tomcourt/enguino/Enguino.jpg

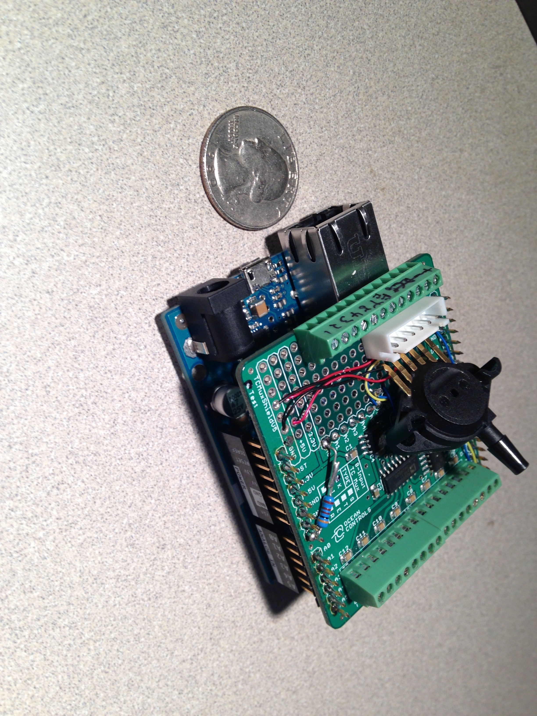
Enguino.jpg
