tomcourt/enguino/AuxDisplayBack.jpg

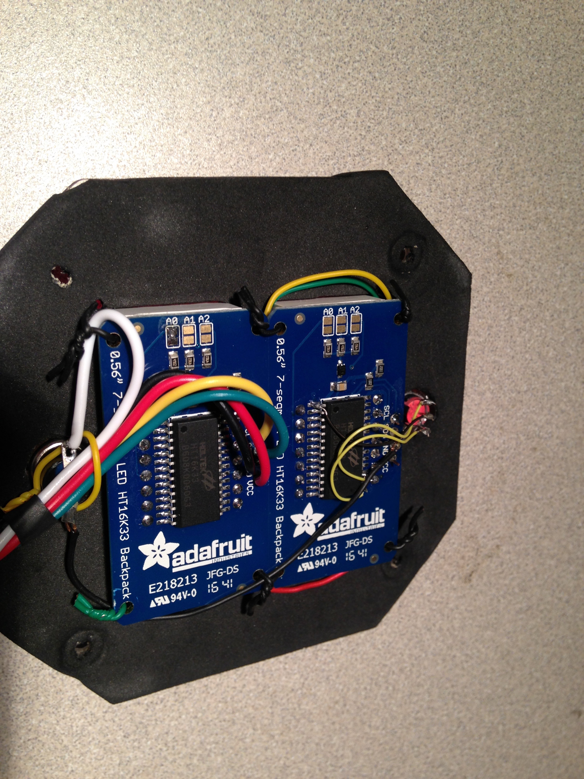
AuxDisplayBack.jpg
