tomcourt/enguino/AuxDisplay.jpg

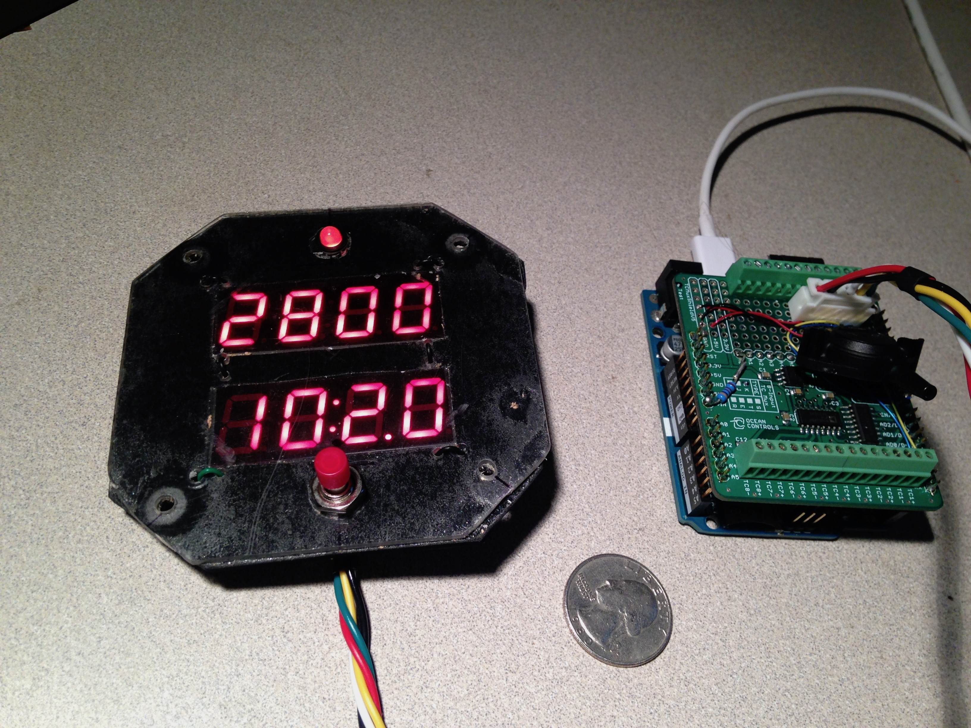
AuxDisplay.jpg
