tomcourt/enguino/LEDrework.jpg

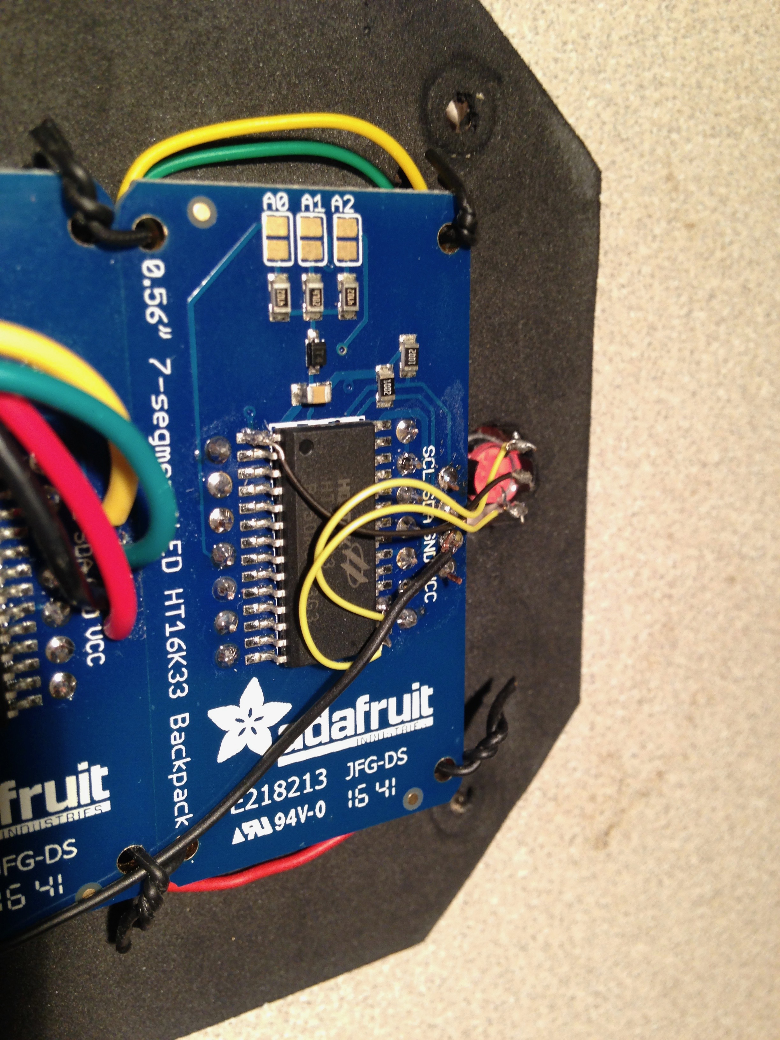
LEDrework.jpg
