tomcourt/enguino/(threads)

Thread 1 (2017-07-31):

24 volts?

tomcourt, 2017-07-31:
Should Enguino support 24 volt electrical systems?

Tilting towards no. 24 volt systems are pricy, not really Enguino's nitch.

If someone wants to substitute components on shield board to make it work and wire it to a  12 volt step down, they'd be welcome to do so.

Thread 11 (2017-07-31):

Arduino Yun

tomcourt, 2017-07-31:
The Arduino Yun would support airplanes lacking a Stratux. The code would need to use the 'bridge' objects instead of the ethernet objects. Use #ifdef AVR_YUN to flex the code.

Thread 2 (2017-07-31):

6 cylinder support?

tomcourt, 2017-07-31:
Should Enguino support 6 cylinders?

I'm thinking if 6 cylinder support is added, the best way is to use a second shield, only partially populated.

A custom shield with an i2c ADC for thermocouples should have support for at least one other jumper address.

TRS-80v2, 2017-08-08:
As an end user, I would like to see 6 cyls. Fantastic work, I just found this today. I am not a coder but hopefully I can help im some aspect.

tomcourt, 2017-08-16:
I'm thinking its possible to use the same shield board populated with little more than the thermocouple ADC and a terminal strip to provide another 8 thermocouples. The new board would be jumpered to a different i2c address so it wouldn't conflict.

The shields would stack on top of each other. This wouldn't be the most convenient  as the extra thermocouples would have to be screwed in, followed by inserting the standard shield and then completing the hookup.

The 4 or less cylinder configuration will come first however.

Thread 4 (2017-07-31):

Percent power

tomcourt, 2017-07-31:
Add percent power to engine display.

This would requite a pressure altitude and OAT probe which means it would be of limited use until a custom shield frees up 4 more analog pins.

The code is tight so other code cleanups may be needed to get this to fit.

MGL has a reasonable formula for percent power in this doc, they have an excel spreadsheet for converting engine power tables to the 3 needed constants: http://www.mglavionics.co.za/Docs/MGL%20EFIS%20G2%20HP%20calculation.pdf

* STP power = (((((MAPmax - ((MAPmax - MAPnow) * K1)) / MAPmax) * RPMnow / RPMmax) ^ K2)
* Altitude adjust = ((1 + K3) * (ATMO_PRESSstp / ATMO_PRESSnow) - K3)
* Temperature adjust = SQRT((519 – (3.58 * PRESS_ALT_FT/1000)) / (460 + OAT_F))
* K1 and K2 are very roughly .1. Default value for K3 is -.695
* Power % = 100 * STP_Power * Altitude_Adjust * Temperature_Adjust

Dynon has an O-320 table: http://preflight.dynonavionics.com/2014/02/did-you-know-percent-power-dynon-way.html

Another couple power spreadsheets: http://www.kilohotel.com/rv8/rvlinks/o360apwr.xls http://www.kilohotel.com/rv8/rvlinks/io360apwr.xls

Thread 5 (2017-07-31):

Custom shield board

tomcourt, 2017-07-31:
A custom shield would be helpful for the typical user who isn't proficient with a soldering iron, particularly if it were populated.

Jumpers would select resistors and maybe filter caps.

A thermocouple board that didn't interfere with the ADC would add 4 more analog inputs (perhaps a latch for the mux or even better, an I2C thermocouple/mux like Linear's LTC2495CUHF#PBF).

An ammeter feature will be desired by some, TI's INA170 High Side Current Shunt Monitor is probably a good part to implement this.

Need to figure out level of interest to figure out method of assembly. A stencil and solder paste for the surface mounts and hand soldering the through holes would probably suffice up to 100/year. Should price out board houses as well.

Thread 6 (2017-07-31):

Custom Aux display board

tomcourt, 2017-07-31:
A custom aux display board would make Enguino easier for installers.

A single HT16K33 LED drive chip could be used for both displays as one chip can support 8 LED digits.

A smaller 7 segment LED modules could be used to allow fitting the display in a 2.25" hole.

A long posted tactile pushbutton switch mounted to the board that would go through a small hole on the display (similar to a digikey EG4356TR-ND) could replace the current switch. The switch wire could be eliminated from the harness if 2 or 3 separate switches are attached to the chip. More switches would be required as the chip can only detect presses, not holds. Switches was be ack/+ and show, pressing both could control dim.

Need to figure out level of interest to figure out method of assembly. A stencil and solder paste for the surface mounts and hand soldering the through holes would probably suffice up to 100/year. Should price out board houses as well.

Thread 9 (2017-07-31):

Thermocouple support without shield

tomcourt, 2017-07-31:
It may be possible to support 2 (or maybe more) thermocouples without the thermocouple multiplexer shield by using the differential mode ADC, 40x gain. Only 8 bits are usable with 40x, the noisy lower bits help with oversampling though. 488 uV per count works out to 21.5 deg. F resolution with a K type thermocouple. The 2.56 volt internal reference would double the resolution and oversampling could probably quadruple it (16x oversample). ADC0 and ADC1 are the negative side, any other ADC pin may be positive. With a filtering cap (10nF) several thermocouples could share a common ground pin.

The internal ATMEGA temperature sensor needs both offset and gain calibration, a 10 deg-C rise is typical as well, 2 point calibration may be much to expect for users. For this reason another analog pin would need to be used for a CJC sensor (Analog TMP36).

Thread 15 (2017-08-01):

3d printed aux display backer plate

tomcourt, 2017-08-01:
Instead of safety wire clamping the Adafruit LED displays to the plexi, they could instead be safety wired or screwed to a backer plate. The backer plate would have a 2 rectangular cut outs for the LED modules with holes matching the mounting holes. #2 screws could be used to mount the dislays. Safety wire using the additional holes provided and the relief slots on the front of the board would also work.

The backer board would also have holes for the LED and the switch.

It would have reinforced areas and pilot holes for standard 3 1/8" instrument mounting screws.

Note - this may not be needed if an aux display circuit board is made.

Thread 16 (2017-08-01):

3d printed Enguino case

tomcourt, 2017-08-01:
I'm imagining two pieces.

The main piece is an open box the boards would drop into. It would have cutouts for ethernet, usb and the power plug on one side.

The main piece would have ears extending from the outside on the bottom would be used for screw mounting to a panel.

4 studs on top of shallow bushings on the bottom of the inside of the box would slightly raise the boards and restrict them moving around. The studs could be snap style pieces if the 'tilt in' can be successfully navigated when dropping the board in.

The second piece is a cover with cutouts for the aux display and pressure sensors and openings on either side for wires. It keeps the boards from tilting up by clamping on the top of the terminal blocks. It would either ratchet along steps in the open box, screw to it or possibly zip ties would secure it.

Note - a custom shield board will likely change the dimensions of the case. And it will certainly change the mounting solutions available.

Thread 18 (2017-08-11):

Thermocouple filtering

tomcourt, 2017-08-11:
Evaluate the need for thermocouple filtering on ADC input. Quite possible that much of the circuitry can be after the MUX meaning an eighth as many components: http://www.ti.com/lit/ug/slau509/slau509.pdf Also keep in mind some of the features may already be part of the IC.

Thread 19 (2017-08-12):

Generic inputs

tomcourt, 2017-08-12:
2 inputs need low ohm pull up (resistive sensor) or pull down (4-20mA sensor) 100-250 ohm 1%. Open both for voltage in.

Other sensors may need alternate pull up values, 1-2K for some thermistors for example.

RC filtering like this? http://www.bgsoflex.com/v22/msv22.html (ignore diode protection)

Thread 21 (2017-08-14):

Fuel flow sensor

tomcourt, 2017-08-14:
Support dual sensors for return flow?

Red cube FT-60 draws 14ma at 8-30 volts. Output (white lead) is open collector, suggested pull up is 1mA, but no more than 15mA. Output is already 'clean' due to 'two-stage comparator', so no filtering needed.

Thread 23 (2017-08-22):

Aux display freezes for second or two

tomcourt, 2017-08-22:
Likely TCP timeout in pollForHttpRequest

Add timing histogram code to track. Test with tablet being turned on and off. Determine if freezing is in connect, reading the http request or writing the gauges.

If freezing in reading the http request, make a reentrant version that maintains state and bugs out if nothing to do.

If freezing in connect, this changes timeouts and retries to reduce the problem.
#include <utility/w5100.h>
W5100.setRetransmissionTime(2000); // 200mS
W5100.setRetransmissionCount(3);     // or less

Writing timeouts will be trickier to fix.
