tomcourt/enguino/EnguinoAuxDisplaySchematic.sch

## EAGLE design EnguinoAuxDisplaySchematic.sch (2018-05-24)

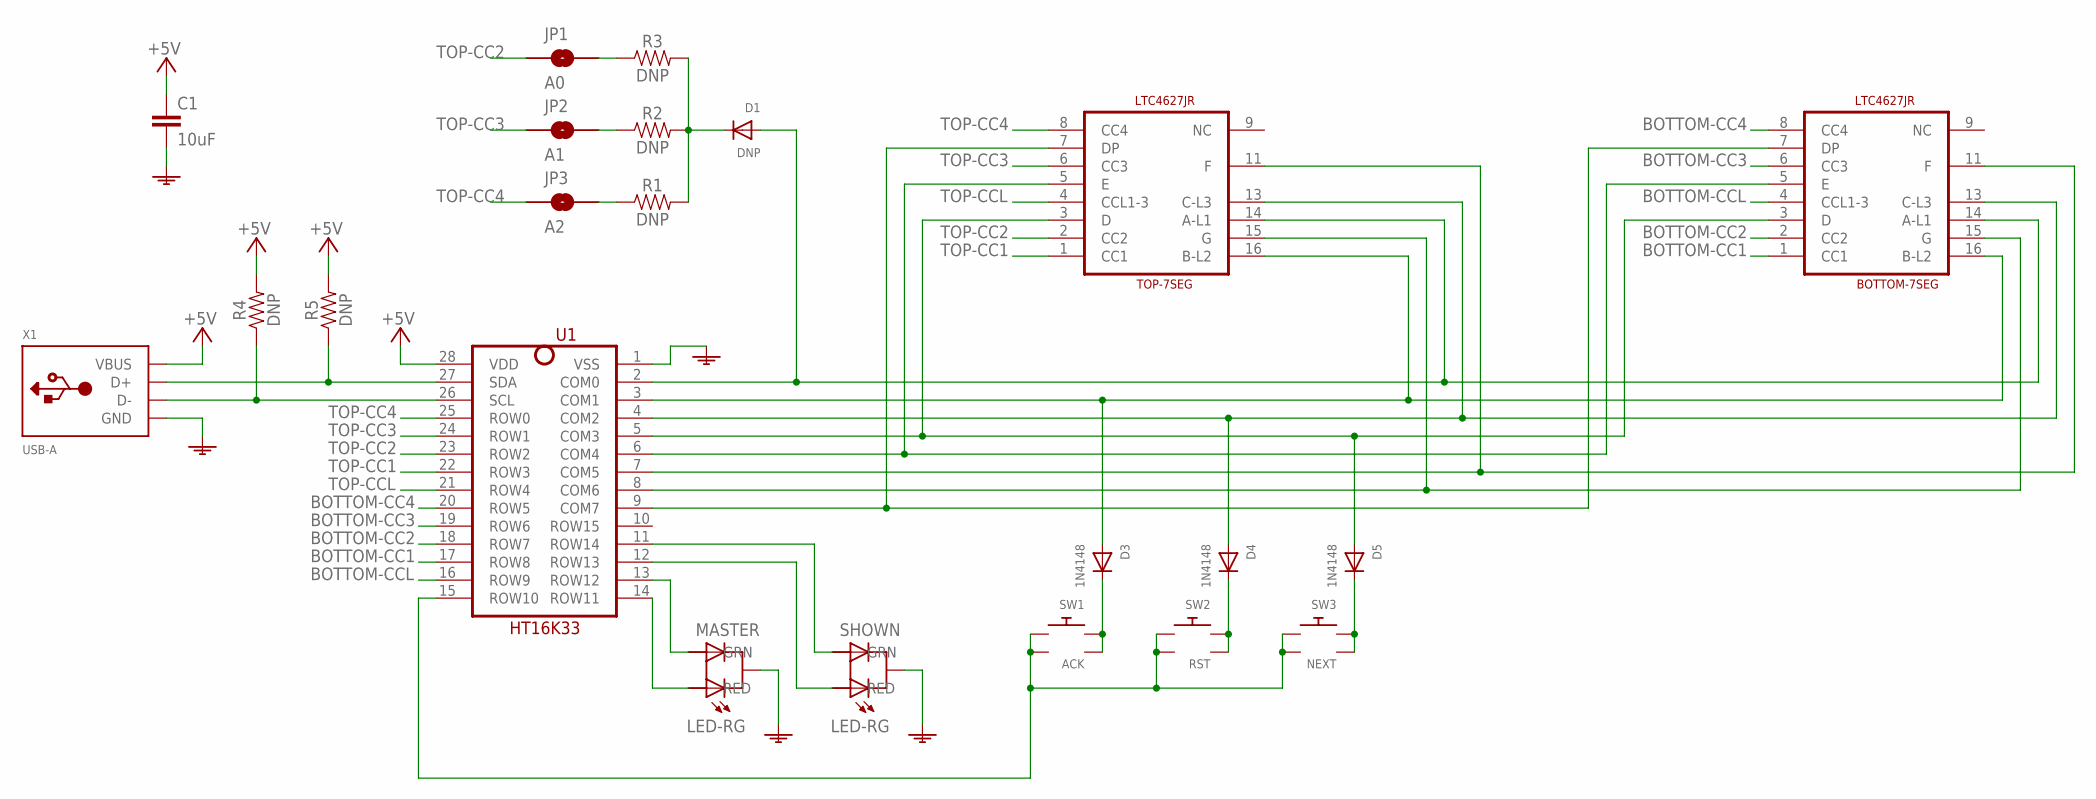
[picture p5: schematic EnguinoAuxDisplaySchematic.sch]

Parts:
BOTTOM-7SEG: LTC4627JR; 7SEG-LED
C1: 10uF; 0805
D1: DNP; SOD-123
D3, D4, D5: 1N4148; SOD-123
JP1: A0; SMT-JUMPER_2_NO_SILK
JP2: A1; SMT-JUMPER_2_NO_SILK
JP3: A2; SMT-JUMPER_2_NO_SILK
MASTER: LED-RG; LED-2-5MM
R1, R2, R3, R4, R5: DNP; 0603
SHOWN: LED-RG; LED-2-5MM
SW1: ACK; BUTTON-TH
SW2: RST; BUTTON-TH
SW3: NEXT; BUTTON-TH
TOP-7SEG: LTC4627JR; 7SEG-LED
U1: HT16K33; SOP28
X1: USB-A; USB-A-AMPHENOL

Connections:
0V: C1.2, MASTER.2 (CC), SHOWN.2 (CC), U1.1 (VSS), X1.P$4 (GND)
1N41N8: SW1.3, SW1.4, SW2.3, SW2.4, SW3.3, SW3.4, U1.15 (ROW10)
+5V: C1.1, R4.2, R5.2, U1.28 (VDD), X1.P$1 (VBUS)
BOTTOM-CC1: BOTTOM-7SEG.1 (CC1), U1.17 (ROW8)
BOTTOM-CC2: BOTTOM-7SEG.2 (CC2), U1.18 (ROW7)
BOTTOM-CC3: BOTTOM-7SEG.6 (CC3), U1.19 (ROW6)
BOTTOM-CC4: BOTTOM-7SEG.8 (CC4), U1.20 (ROW5)
BOTTOM-CCL: BOTTOM-7SEG.4 (CCL1-3), U1.16 (ROW9)
unnamed: JP1.2, R3.1
unnamed: R5.1, U1.27 (SDA), X1.P$3 (D+)
unnamed: BOTTOM-7SEG.14 (A-L1), D1.A, TOP-7SEG.14 (A-L1), U1.2 (COM0)
unnamed: BOTTOM-7SEG.16 (B-L2), D3.A, TOP-7SEG.16 (B-L2), U1.3 (COM1)
unnamed: BOTTOM-7SEG.13 (C-L3), D4.A, TOP-7SEG.13 (C-L3), U1.4 (COM2)
unnamed: BOTTOM-7SEG.3 (D), D5.A, TOP-7SEG.3 (D), U1.5 (COM3)
unnamed: BOTTOM-7SEG.5 (E), TOP-7SEG.5 (E), U1.6 (COM4)
unnamed: BOTTOM-7SEG.11 (F), TOP-7SEG.11 (F), U1.7 (COM5)
unnamed: BOTTOM-7SEG.15 (G), TOP-7SEG.15 (G), U1.8 (COM6)
unnamed: BOTTOM-7SEG.7 (DP), TOP-7SEG.7 (DP), U1.9 (COM7)
unnamed: R4.1, U1.26 (SCL), X1.P$2 (D-)
unnamed: JP2.2, R2.1
unnamed: JP3.2, R1.1
unnamed: D1.C, R1.2, R2.2, R3.2
unnamed: D3.C, SW1.1, SW1.2
unnamed: D4.C, SW2.1, SW2.2
unnamed: D5.C, SW3.1, SW3.2
unnamed: MASTER.1 (RED), U1.14 (ROW11)
unnamed: MASTER.3 (GRN), U1.13 (ROW12)
unnamed: SHOWN.1 (RED), U1.12 (ROW13)
unnamed: SHOWN.3 (GRN), U1.11 (ROW14)
TOP-CC1: TOP-7SEG.1 (CC1), U1.22 (ROW3)
TOP-CC2: JP1.1, TOP-7SEG.2 (CC2), U1.23 (ROW2)
TOP-CC3: JP2.1, TOP-7SEG.6 (CC3), U1.24 (ROW1)
TOP-CC4: JP3.1, TOP-7SEG.8 (CC4), U1.25 (ROW0)
TOP-CCL: TOP-7SEG.4 (CCL1-3), U1.21 (ROW4)
