tomcourt/enguino/EnguinoShieldSchematic.sch

## EAGLE design EnguinoShieldSchematic.sch (2018-05-24)

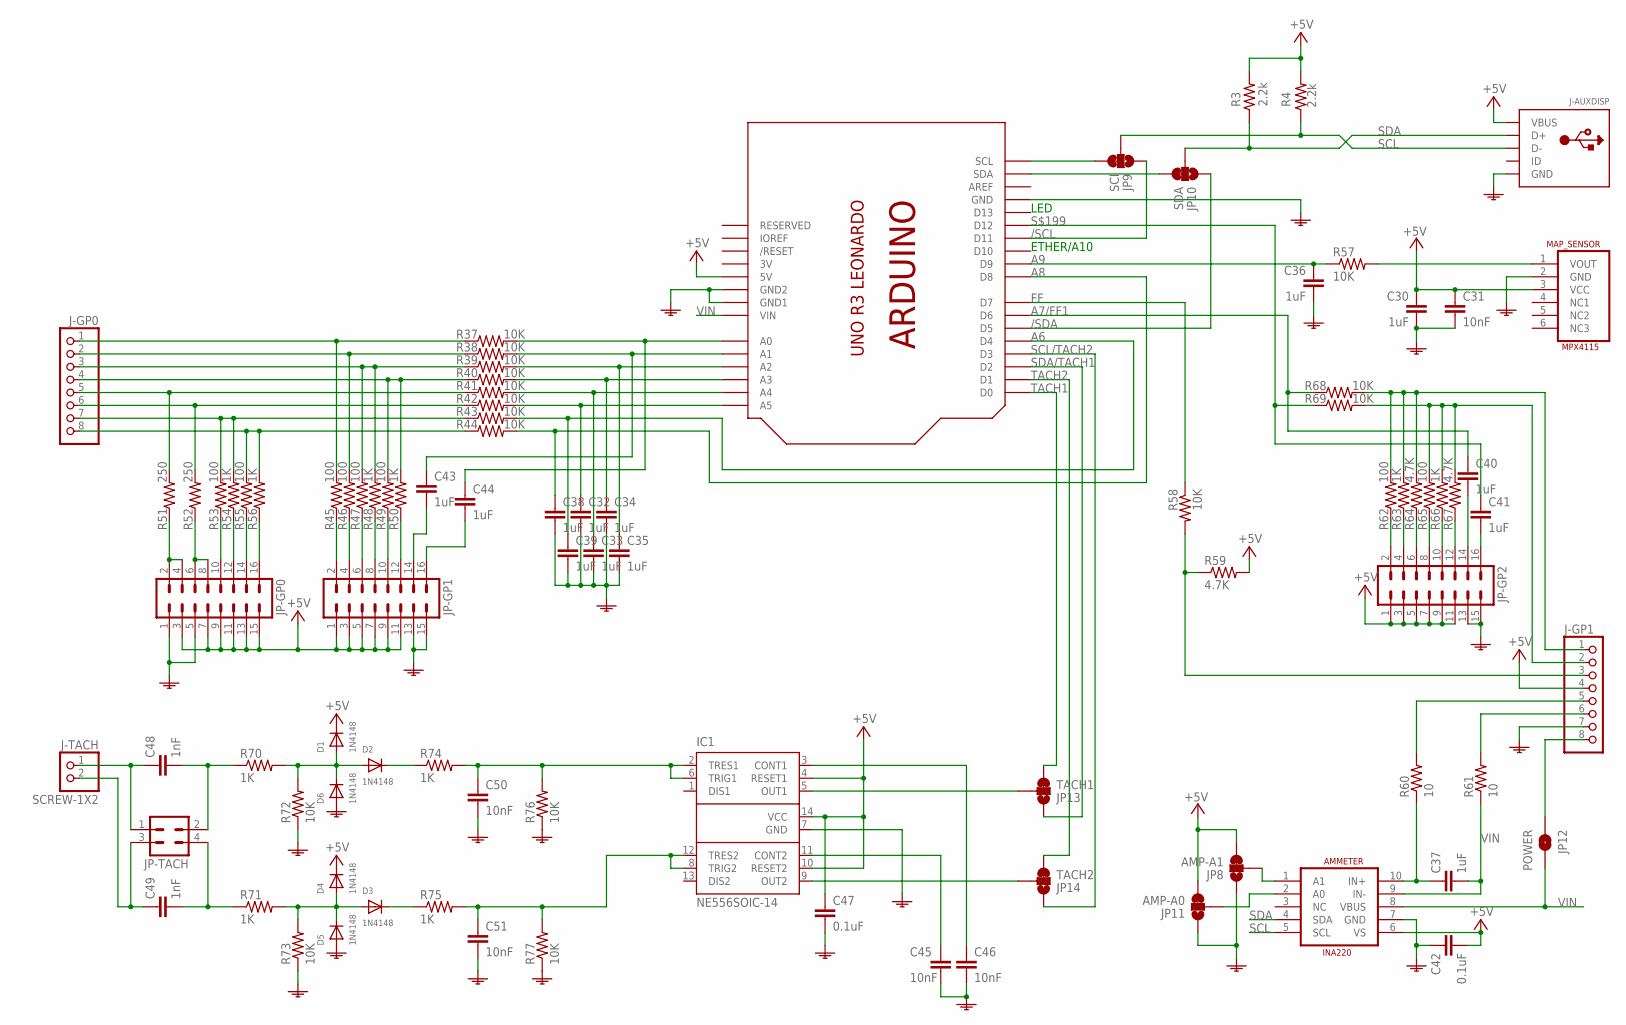
[picture p6: schematic EnguinoShieldSchematic.sch, sheet 1]

Parts:
AMMETER: INA220; VSSOP-10
C30, C32, C33, C34, C35, C36, C37, C38, C39, C40, C41, C43, C44: 1uF; 0603
C31, C45, C46, C50, C51: 10nF; 0603
C42, C47: 0.1uF; 0603
C48, C49: 1nF; 0603
D1, D2, D3, D4, D5, D6: 1N4148; SOD-123
IC1: NE556SOIC-14; SO14
J-AUXDISP: USB-B-MICRO; MICRO-USB-AMPHERNOL
J-GP0, J-GP1: SCREW-1X8BIG; 1X08-BIG
J-TACH: SCREW-1X2; 1X02-BIG
JP8: AMP-A1; SMT-JUMPER_3_NC
JP9: SCl; SMT-JUMPER_3_NC
JP10: SDA; SMT-JUMPER_3_NC
JP11: AMP-A0; SMT-JUMPER_3_NC
JP12: POWER; SMT-JUMPER_2_NO
JP13: TACH1; SMT-JUMPER_3_NC
JP14: TACH2; SMT-JUMPER_3_NC
JP-GP0, JP-GP1, JP-GP2: MA08-2
JP-TACH: MA02-2
MAP_SENSOR: MPX4115; MPX4115-AP
R3, R4: 2.2k; 0603
R37, R38, R39, R40, R41, R42, R43, R44, R57, R58, R68, R69, R72, R73, R76, R77: 10K; R0603
R45, R46, R47, R49, R53, R55, R62, R65: 100; R0603
R48, R50, R54, R56, R63, R66, R70, R71, R74, R75: 1K; R0603
R51, R52: 250; R0603
R59, R64, R67: 4.7K; R0603
R60, R61: 10; R0603
U1: ARDUINOR3LEO-DIMENSION; ARDUINOR3

Connections:
0V: AMMETER.7 (GND), C30.2, C31.2, C32.2, C33.2, C34.2, C35.2, C36.2, C38.2, C39.2, C42.1, C45.2, C46.2, C47.2, C50.2, C51.2, D5.A, D6.A, IC1.7 (GND), J-AUXDISP.P$5 (GND), J-GP1.7, JP8.1, JP11.1, JP-GP0.1, JP-GP0.5, JP-GP1.13, JP-GP1.15, JP-GP2.13, JP-GP2.15, MAP_SENSOR.2 (GND), R72.1, R73.1, R76.1, R77.1, U1.GND, U1.GND1, U1.GND2
+5V: AMMETER.6 (VS), C30.1, C31.1, C42.2, C47.1, D1.C, D4.C, IC1.4 (RESET1), IC1.10 (RESET2), IC1.14 (VCC), J-AUXDISP.P$1 (VBUS), J-GP1.4, JP8.3, JP11.3, JP-GP0.3, JP-GP0.7, JP-GP0.9, JP-GP0.11, JP-GP0.13, JP-GP0.15, JP-GP1.1, JP-GP1.3, JP-GP1.5, JP-GP1.7, JP-GP1.9, JP-GP1.11, JP-GP2.1, JP-GP2.3, JP-GP2.5, JP-GP2.7, JP-GP2.9, JP-GP2.11, MAP_SENSOR.3 (VCC), R3.2, R4.2, R59.2, U1.5V
/SCL: JP9.1, U1.D11
/SDA: JP10.1, U1.D5
A6: C39.1, R43.2, U1.D4
A7/FF1: C40.1, R68.1, U1.D6
A8: C38.1, R44.2, U1.D8
A9: C36.1, R57.1, U1.D9
FF: R58.1, U1.D7
JP7: C49.1, J-TACH.2, JP-TACH.3
unnamed: J-GP0.7, R43.1, R53.2, R54.2
unnamed: J-GP0.1, R37.1, R45.2
unnamed: J-GP0.2, R38.1, R46.2
unnamed: C44.1, R37.2, U1.A0
unnamed: C43.2, JP-GP1.14
unnamed: C35.1, R39.2, U1.A2
unnamed: C34.1, R40.2, U1.A3
unnamed: C33.1, R41.2, U1.A4
unnamed: C32.1, R42.2, U1.A5
unnamed: J-GP0.3, R39.1, R47.2, R48.2
unnamed: J-GP0.4, R40.1, R49.2, R50.2
unnamed: J-GP0.5, R41.1, R51.2
unnamed: J-GP0.6, R42.1, R52.2
unnamed: J-GP0.8, R44.1, R55.2, R56.2
unnamed: C43.1, R38.2, U1.A1
unnamed: C44.2, JP-GP1.16
unnamed: JP-GP0.2, JP-GP0.4, R51.1
unnamed: JP-GP1.2, R45.1
unnamed: JP-GP1.4, R46.1
unnamed: JP-GP1.6, R47.1
unnamed: JP-GP1.8, R48.1
unnamed: JP-GP1.10, R49.1
unnamed: JP-GP1.12, R50.1
unnamed: JP-GP0.6, JP-GP0.8, R52.1
unnamed: JP9.3, U1.SCL
unnamed: JP-GP0.16, R56.1
unnamed: JP-GP0.14, R55.1
unnamed: JP-GP0.12, R54.1
unnamed: JP-GP0.10, R53.1
unnamed: MAP_SENSOR.1 (VOUT), R57.2
unnamed: J-GP1.2, R65.2, R66.2, R67.2, R69.2
unnamed: J-GP1.1, R62.2, R63.2, R64.2, R68.2
unnamed: JP10.3, U1.SDA
unnamed: J-GP1.3, R58.2, R59.1
unnamed: AMMETER.9 (IN-), C37.2, R61.1
unnamed: AMMETER.10 (IN+), C37.1, R60.1
unnamed: J-GP1.5, R60.2
unnamed: JP-GP2.2, R62.1
unnamed: AMMETER.1 (A1), JP8.2
unnamed: AMMETER.2 (A0), JP11.2
unnamed: JP-GP2.4, R63.1
unnamed: JP-GP2.6, R64.1
unnamed: JP-GP2.8, R65.1
unnamed: JP-GP2.10, R66.1
unnamed: JP-GP2.12, R67.1
unnamed: IC1.9 (OUT2), JP14.2
unnamed: C40.2, JP-GP2.14
unnamed: IC1.5 (OUT1), JP13.2
unnamed: C41.2, JP-GP2.16
unnamed: C50.1, IC1.2 (TRES1), IC1.6 (TRIG1), R74.2, R76.2
unnamed: C45.1, IC1.11 (CONT2)
unnamed: C51.1, IC1.8 (TRIG2), IC1.12 (TRES2), R75.2, R77.2
unnamed: C46.1, IC1.3 (CONT1)
unnamed: C48.1, J-TACH.1, JP-TACH.1
unnamed: J-GP1.6, R61.2
unnamed: C48.2, JP-TACH.2, R70.1
unnamed: C49.2, JP-TACH.4, R71.1
unnamed: D1.A, D2.A, D6.C, R70.2, R72.2
unnamed: D3.A, D4.A, D5.C, R71.2, R73.2
unnamed: D2.C, R74.1
unnamed: D3.C, R75.1
S$199: C41.1, R69.1, U1.D12
SCL: AMMETER.5 (SCL), J-AUXDISP.P$2 (D-), JP9.2, R4.1
SCL/TACH2: JP14.1, U1.D3
SDA: AMMETER.4 (SDA), J-AUXDISP.P$3 (D+), JP10.2, R3.1
SDA/TACH1: JP13.1, U1.D2
TACH1: JP13.3, U1.D0
TACH2: JP14.3, U1.D1
VIN: AMMETER.8 (VBUS), J-GP1.8, JP12.1, JP12.2, U1.VIN

Notes on the sheet:
LED
ETHER/A10

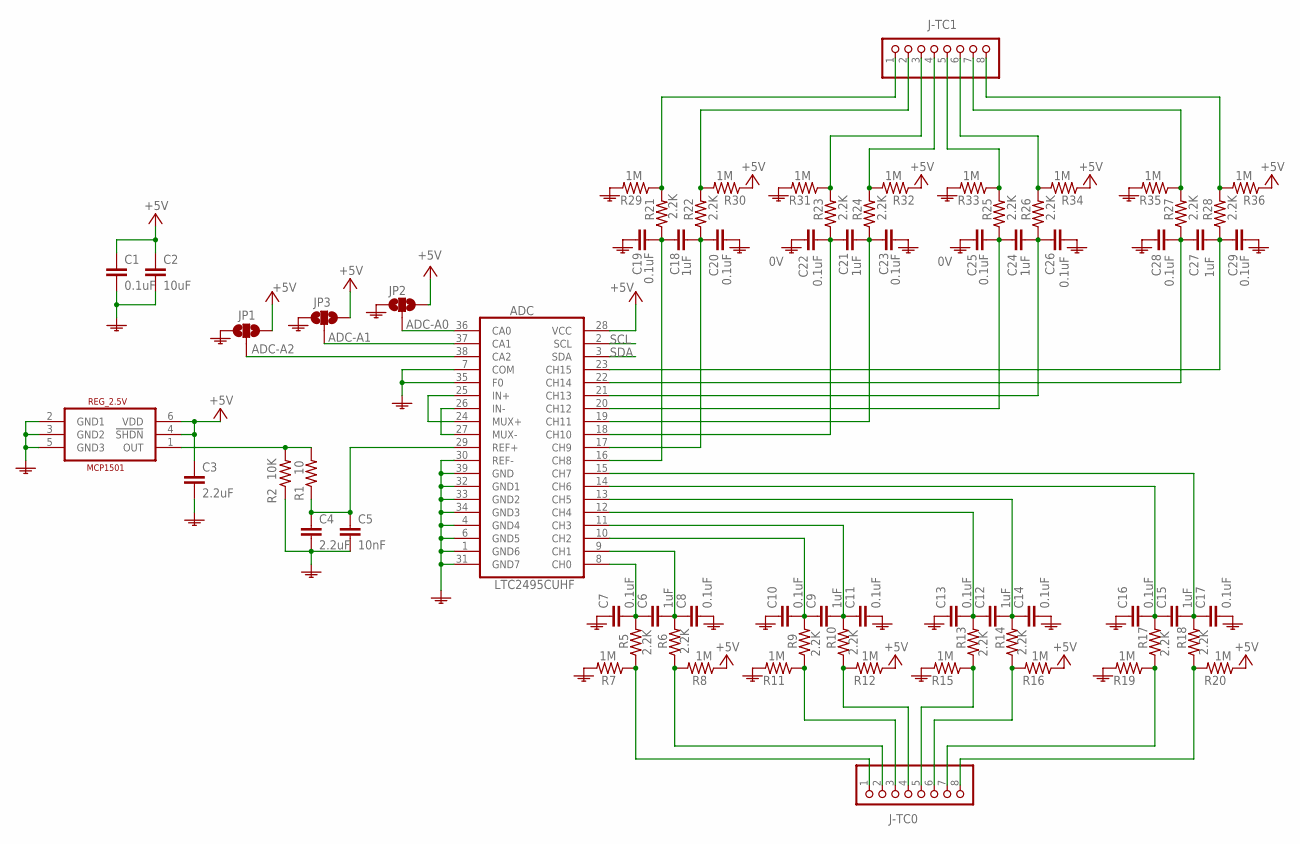
[picture p7: schematic EnguinoShieldSchematic.sch, sheet 2]

Parts:
ADC: LTC2495CUHF; QFN-38
C1, C7, C8, C10, C11, C13, C14, C16, C17, C19, C20, C22, C23, C25, C26, C28, C29: 0.1uF; 0603
C2: 10uF; 0603
C3, C4: 2.2uF; 0603
C5: 10nF; 0603
C6, C9, C12, C15, C18, C21, C24, C27: 1uF; 0603
J-TC0, J-TC1: SCREW-1X8BIG; 1X08-BIG
JP1: ADC-A2; SMT-JUMPER_3_NO
JP2: ADC-A0; SMT-JUMPER_3_NO
JP3: ADC-A1; SMT-JUMPER_3_NO
R1: 10; R0603
R2: 10K; R0603
R5, R6, R9, R10, R13, R14, R17, R18, R21, R22, R23, R24, R25, R26, R27, R28: 2.2K; R0603
R7, R8, R11, R12, R15, R16, R19, R20, R29, R30, R31, R32, R33, R34, R35, R36: 1M; R0603
REG_2.5V: MCP1501; SOT23-6

Connections:
0V: ADC.1 (GND6), ADC.4 (GND4), ADC.6 (GND5), ADC.7 (COM), ADC.30 (REF-), ADC.31 (GND7), ADC.32 (GND1), ADC.33 (GND2), ADC.34 (GND3), ADC.35 (F0), ADC.39 (GND), C1.2, C2.2, C3.2, C4.2, C5.2, C7.1, C8.2, C10.1, C11.2, C13.1, C14.2, C16.1, C17.2, C19.1, C20.2, C22.1, C23.2, C25.1, C26.2, C28.1, C29.2, JP1.1, JP2.1, JP3.1, R2.1, R7.2, R11.2, R15.2, R19.2, R29.2, R31.2, R33.2, R35.2, REG_2.5V.2 (GND1), REG_2.5V.3 (GND2), REG_2.5V.5 (GND3)
+5V: ADC.28 (VCC), C1.1, C2.1, C3.1, JP1.3, JP2.3, JP3.3, R8.1, R12.1, R16.1, R20.1, R30.1, R32.1, R34.1, R36.1, REG_2.5V.4 (!SHDN), REG_2.5V.6 (VDD)
unnamed: ADC.26 (IN-), ADC.27 (MUX-)
unnamed: ADC.24 (MUX+), ADC.25 (IN+)
unnamed: ADC.38 (CA2), JP1.2
unnamed: ADC.37 (CA1), JP3.2
unnamed: ADC.36 (CA0), JP2.2
unnamed: ADC.8 (CH0), C6.1, C7.2, R5.2
unnamed: R1.2, R2.2, REG_2.5V.1 (OUT)
unnamed: ADC.9 (CH1), C6.2, C8.1, R6.2
unnamed: J-TC0.2, R6.1, R8.2
unnamed: ADC.29 (REF+), C4.1, C5.1, R1.1
unnamed: J-TC0.1, R5.1, R7.1
unnamed: ADC.12 (CH4), C12.1, C13.2, R13.2
unnamed: ADC.10 (CH2), C9.1, C10.2, R9.2
unnamed: ADC.11 (CH3), C9.2, C11.1, R10.2
unnamed: J-TC0.4, R10.1, R12.2
unnamed: J-TC0.3, R9.1, R11.1
unnamed: ADC.13 (CH5), C12.2, C14.1, R14.2
unnamed: J-TC0.6, R14.1, R16.2
unnamed: J-TC0.5, R13.1, R15.1
unnamed: ADC.14 (CH6), C15.1, C16.2, R17.2
unnamed: ADC.15 (CH7), C15.2, C17.1, R18.2
unnamed: J-TC0.8, R18.1, R20.2
unnamed: J-TC0.7, R17.1, R19.1
unnamed: ADC.16 (CH8), C18.1, C19.2, R21.1
unnamed: ADC.17 (CH9), C18.2, C20.1, R22.1
unnamed: ADC.18 (CH10), C21.1, C22.2, R23.1
unnamed: ADC.19 (CH11), C21.2, C23.1, R24.1
unnamed: ADC.20 (CH12), C24.1, C25.2, R25.1
unnamed: ADC.21 (CH13), C24.2, C26.1, R26.1
unnamed: ADC.22 (CH14), C27.1, C28.2, R27.1
unnamed: ADC.23 (CH15), C27.2, C29.1, R28.1
unnamed: J-TC1.1, R21.2, R29.1
unnamed: J-TC1.2, R22.2, R30.2
unnamed: J-TC1.3, R23.2, R31.1
unnamed: J-TC1.4, R24.2, R32.2
unnamed: J-TC1.5, R25.2, R33.1
unnamed: J-TC1.6, R26.2, R34.2
unnamed: J-TC1.7, R27.2, R35.1
unnamed: J-TC1.8, R28.2, R36.2
SCL: ADC.2 (SCL)
SDA: ADC.3 (SDA)
