tomcourt/enguino/enguino/config.h

// Copyright 2017, Thomas Court
//
// User configuration for enguino
// ------------------------------
// This configuration file assumes Carburated Lycoming O-360 or O-320 with Van's Aircraft sensors. Fuel level senders are Van's for the RV-6.
// Confirm the yellow and red line (cauation and warning) numbers are correct for your engine. Confirm that your sensors are compatible.
// And most importanly confirm that your fuel gauges correctly reflect fuel in the tank from all readings from full to empty.

//  This file is part of Enguino.
//
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


#define TACH_DIVIDER 4

#define CYLINDERS 4     // used for how may horizontal gauges are drawn for CHT/EGT

#define DEFAULT_K_FACTOR (68000L / 40)  // for fuel flow transducer

// Exceed any of these and engine will be considered 'running'. Hobbs time will accumulate and engine alerts will appear. A 0 value will cause that sensor to be ignored.
#define RUN_VOLT 130
#define RUN_OILP 250
#define RUN_TACH 200

// By default each analog sensor is averaged 4 times over a half a second period
// Because the fuel tank level 'sloshes' with a period of several seconds a longer average is needed
#define LONG_AVERAGE_LENGTH 64   // long average period in eigths of a second, every 8 seconds the reading will be half again as close to accurate, i.e. in a minute it will be within 1% 
const bool longAverageByPin[12] = { false, false, false, false, true, true, false, false, false, false, false, false };

// Sensor defintions and scaling
// -----------------------------
// The sensors are scaled using the following formula, are scaled as follow: y = factor * (adc + offset).
// All of these numbers must be integers. Factors are represented as a ratio with an integer numerator and a denominator of 8192.
// Some numeric values are multipled by 10 and then have a decimal point added when displayed.
// SCALE(1.) returns the raw values (ADC, RPM's). SCALE(range/full_scale) returns a value from 0 to range.
// The gauge pointers vary from 0 to 1000. Use GMIN() and GRNG to set the graphs b and m values based on lowest input and input range (hi-low) respectively.
// Manifold pressure sensor = P(inch) = V(full) * 32.811 + 3.117 or V = (P-3.117)/32.811

//   sensor-type    range
// --------------  --------
// st_r240to33     0 - 1000   proportional on resistance of sensor forming resistor divider
// st_thermistor   -/+ xxxx   degrees either F or C. 
// st_volts1       0 - 1000   1 mV/per count
// st_volts5       0 - 1000   5 mV/per count
// st_k_type_tcC   0 - 4000   0-1000 degrees C. in quarters
// st_j_type_tcC   0 - 4000   0-1000 degrees C. in quarters
// st_k_type_tcF   0 - 4000   32-1832 degrees F. in quarters
// st_j_type_tcF   0 - 4000   32-1832 degrees F. in quarters
// st_unit                    unit values, RPM, fuel flow, hobbs

//                      sensor-type,  pin, decimal, voffset,         vfactor,            goffset,          gfactor,lowWarning,lowCaution,highCaution,highWarning
const Sensor voltS =  { st_volts5,      0,       1,       0,     SCALE(.200),    GMIN(100*fromV),    GRNG(60*fromV),      110,      130,      9999,       160 };
const Sensor oilpS =  { st_volts5,      1,       0,    -436,    SCALE(-.310),               -436,     SCALE(-3.095),       25,       55,      9999,        95 };
const Sensor oiltS =  { st_thermistor,  2,       0,       0,      SCALE(1.),            GMIN(50),         GRNG(200),       -1,      140,      9999,       245 };
const Sensor fuelpS = { st_volts1,      3,       1,    -626,   SCALE(-.395),               -626,      SCALE(-2.634),        5,       20,        60,        80 };
const Sensor fuellS = { st_volts5, DUAL(4),      1,    -490,    SCALE(-.402),               -490,      SCALE(-2.512),       25,       50,      9999,       999 };
const Sensor mapS =   { st_volts5,      8,       1,     102,   SCALE(.32811),          GMIN(210),GRNG(1000*25/32.811),     -1,       -1,      9999,      9999 };
const Sensor chtS =   { st_k_type_tcF, 16,       0,       0,      SCALE(.25),        GMIN(100*4),       GRNG(400*4),       -1,      150,       400,       495 };
const Sensor egtS =   { st_k_type_tcF, 20,       0,       0,      SCALE(.25),       GMIN(1000*4),       GRNG(600*4),       -1,       -1,      9999,      9999 };
const Sensor tachS =  { st_unit,    TACH_SENSOR, 0,       0,       SCALE(1.),            GMIN(0),        GRNG(3000),       -1,      500,      9999,      2700 };
const Sensor fuelfS = { st_unit,   FUELF_SENSOR, 1,       0,       SCALE(1.),            GMIN(0),        GRNG(150),        -1,       -1,      9999,      9999 };
const Sensor fuelrS = { st_unit,   FUELR_SENSOR, 1,       0,       SCALE(1.),            GMIN(0),        GRNG(400),        -1,       -1,      9999,      9999 };
const Sensor hobbsS = { st_unit,   HOBBS_SENSOR, 1,       0,       SCALE(1.),            GMIN(0),       GRNG(1000),        -1,       -1,      9999,      9999 };

// Label and gradations
// --------------------
string      oilpLV[] =  {     "80",            "60",           "40",           "20"  };
const short oilpLP[] =  { VSEG(80./100.),  VSEG(60./100.), VSEG(40./100.), VSEG(20./100.) };
string      oiltLV[] =  {     "200",           "150",          "100" };
const short oiltLP[] =  { VSEG(150./200.), VSEG(100./200.), VSEG(50./200.) };     // offset and range offset by 50 deg-F
string      voltLV[] =  {    "14",        "12"  };
const short voltLP[] =  { VSEG(4./6.), VSEG(2./6.) };                             // offset and range offset by 10 volts
string      fuelpLV[] =   {     "8",           "6",          "4",          "2" };
const short fuelpLP[] =  { VSEG(8./10.),  VSEG(6./10.), VSEG(4./10.), VSEG(2./10.) };
string      fuellLV[] =  {     "15",          "10",          "5",          "2.5" };
const short fuellLP[] =  { VSEG(15./16.), VSEG(10./16.), VSEG(5./16.), VSEG(2.5/16.) };
string      chtLV[] =  {     "200&deg;F",     "300&deg;F",     "400&deg;F" };
const short chtLP[] =  { HSEG(100./400.), HSEG(200./400.), HSEG(300./400.) };    // offset and range offset by 100 deg-F
string      egtLV[] =  {    "1150&deg;",     "1300&deg;",     "1450&deg;" };
const short egtLP[] =  { HSEG(150./600.), HSEG(300./600.), HSEG(450./600.) };    // offset and range offset by 1000 deg-F

// Color regions
// -------------
string oilpRC[] = { red,            yellow,         green,          red     };
short  oilpRP[] = { VSEG(25./100.), VSEG(55./100.), VSEG(95./100.), VSEG(1) };
string oiltRC[] = { yellow,         green,           red     };
short  oiltRP[] = { VSEG(90./200.), VSEG(195./200.), VSEG(1) };     // offset and range offset by 50 deg-F
string voltRC[] = { red,         yellow,      green,       yellow,       red     };
short  voltRP[] = { VSEG(1./6.), VSEG(3./6.), VSEG(5./6.), VSEG(5.9/6.), VSEG(1) };      // offset and range offset by 10 volts
string fuelpRC[] = { red,          yellow,       green,        yellow,       red     };
short  fuelpRP[] = { VSEG(.5/10.), VSEG(2./10.), VSEG(6./10.), VSEG(8./10.), VSEG(1) };
string fuellRC[] = { red,           yellow,       green   };
short  fuellRP[] = { VSEG(2.5/16.), VSEG(5./16.), VSEG(1) };
string tachRC[] = { yellow,              green,                red       };
short  tachRP[] = { ARCX(500./3000.),    ARCX(2700./3000.),    ARCX(1),       // x
                    ARCY(500./3000.),    ARCY(2700./3000.),    ARCY(1),       // y
                    0,                   0,                    0         };   // arc segmenet is > 180 degrees
string mapRC[] = { green    };
short  mapRP[] = { ARCX(1),        // x
                   ARCY(1),        // y
                   1      };       // arc segmenet is > 180 degrees
string chtRC[] = { yellow,         green,           yellow,          red     };
short  chtRP[] = { HSEG(50./400.), HSEG(300./400.), HSEG(395./400.), HSEG(1) };     // offset and range offset by 100 deg-F

// Gauge layout for screen
// -----------------------
// bank values are to easily adjust the row of vertical gauges
#define BANKX 3500    // bank of misc vertical gauges, starting X position
#define BANKDX 1750   // distance between each vertical gauage
#define bank(x) (BANKX+(x)*BANKDX)    // x position for each gauge in the 'bank' of vertical gauges

const Gauge gauges[] = {
  //  x,    y,  style,     label1, label2, units,    labVal,   labPt,        num,  regClr,   regPt,        num,  sensor
  {bank(0), 0,  gs_vert,   "OIL",  "PRES", "psi",    oilpLV,  oilpLP,  N(oilpLV),  oilpRC,  oilpRP,  N(oilpRC),  &oilpS},
  {bank(1), 0,  gs_vert,   "OIL",  "TEMP", "&deg;F", oiltLV,  oiltLP,  N(oiltLV),  oiltRC,  oiltRP,  N(oiltRC),  &oiltS},
  {bank(2), 0,  gs_vert,   "",     "VOLT", "volt",   voltLV,  voltLP,  N(voltLV),  voltRC,  voltRP,  N(voltRC),  &voltS},
  {bank(3), 0,  gs_vert,   "FUEL", "PRES", "psi",    fuelpLV, fuelpLP, N(fuelpLV), fuelpRC, fuelpRP, N(fuelpRC), &fuelpS},
  {bank(4), 0,  gs_pair,   "FUEL", "",     "gal",    fuellLV, fuellLP, N(fuellLV), fuellRC, fuellRP, N(fuellRC), &fuellS},
  {100,     0,  gs_round,  "TACH", "",     "rpm",    0,       0,       0,          tachRC,  tachRP,  N(tachRC),  &tachS},
  {100,  3200,  gs_round,  "MP",   "",     "in-hg",  0,       0,       0,          mapRC,   mapRP,   N(mapRC),   &mapS},
  {2950, 6150, gs_horiz,   "CHT",  "",     "",       chtLV,   chtLP,   N(chtLV),   chtRC,   chtRP,   N(chtRC),   &chtS},
  {2950, 6150, gs_egt,     "EGT",  "",     "",       egtLV,   egtLP,   N(egtLV),   0,       0,       0,          &egtS},
  {800,  6650, gs_infobox, "",     "",     "",       0,       0,       0,          0,       0,       0,          0}
};

// Guage layout for aux display
// ----------------------------
// Layout is text, top-sensor, bottom-sensor. Sensor value is displayed in the top line if text is blank, otherwise top sensor is used to show warning/caution and low/high on top line
AuxDisplay auxDisplay[] = {
  AUX(H,o,b,b, 0,       &hobbsS),
  AUX(b,A,t, , &voltS,  &voltS),
  AUX( , , , , &tachS,  &fuellS),   // default page
  AUX(O,P, , , &oilpS,  &oilpS),
  AUX(O,t, , , &oiltS,  &oiltS),
  AUX(F,P, , , &fuelpS, &fuelpS),
  AUX(A,L,t, , &voltS,  &voltS),
};

// number of pages shown on startup, immedietly after the startup pages is the default page
#define AUX_STARTUP_PAGES 2

// seconds before aux goes back to default page (assuming no un-acknowleged alerts), max. value 30
#define SHOW_DEFAULT_AUX_PAGE_TIMEOUT 10
