tomcourt/enguino/enguino/sensors.h

// Copyright 2017, Thomas Court
//
//  This file is part of Enguino.
//  
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


// Digital pin assignments
#define FUELF_SIGNAL 1 
#define TACH_SIGNAL  0

#define HOBBS_COUNT_INTERVAL (3600/40)    // update hobbs 40 times an hour

extern volatile short tcTemp[9];    // in quarter deg. C, tcTemp[8] is the interal reference temp, disable IRQ's to access these

typedef union {
  long accumulate;
  short moving[4];
} Sample;

Sample adcSample[13];   // adcSample[12] is tachometer
byte adcIndex;

volatile short tachCount;
volatile unsigned long latestTach_uS;
unsigned long savedTach_uS;
short rpm10;

volatile word fflowCount;
volatile word fflowRunning;
word fflowRate;     // in k-factor counts for last 2 seconds, ~3.8 counts is .1 GPH
word ffRunning[4];
byte ffRunningInx;

byte hobbsCount = HOBBS_COUNT_INTERVAL/2;  // in order to prevent cumulative hobbs error assume half a hobbs count of engine run time was lost on last shutdown


static const byte thermistorBS[] = { 
  4,4,4,4,
  4,5,5,5,
  5,5,5,5,
  5,5,4,4
};

static const short thermistorYV[] = {
  303,280,262,248,
  236,224,205,188,
  173,158,144,128,
  112,93,69,53,
  31
};

const InterpolateTable thermistor = { 64, 17, thermistorBS, thermistorYV }; 

static const byte r240to33BS[] = { 
  5, 5, 5, 5, 4, 4, 4, 4, 4, 4, 4, 4, 4, 4, 
  4, 4, 4, 4, 4, 4, 4, 4, 4, 4, 4, 4, 4 
};

static const short r240to33YV[] = { 
  1105, 1064, 1019, 972, 921, 894, 866,
   837,  806,  775, 742, 707, 671, 634,
   595,  553,  510, 465, 417, 367, 314,
   258,  199,  137,  70,   0, -75, -155  
};

const InterpolateTable r240to33 = { 48,  28, r240to33BS, r240to33YV };



#if SIMULATE_SENSORS
#define ADC_MP(x) (short)(1000L*((x)-3.117)/32.811 +.5)

byte simState = 0;

short simulate[3][24] = {
{  
  1000L*12/20,   // 12 v
  246,  // OP - 60 psi
  200,        // 200 deg-F
  500,    // FP - 4 psi
  264,   // 10 gal
  356,    // 5 gal
  0, 0,
  0, ADC_MP(20), 0, 0, 4321, 3500, 122, 2300,
  310*4,320*4,330*4,340*4,        // CHT
  1100*4,1200*4,1300*4,1400*4     // EGT
},
{  
  1000L*14/20,    // 14 v
  246,   // OP - 60 psi
  200,            // 200 deg-F
  500,     // FP - 4 psi           
  264,    // 10 gal
  420,     // 2 gal
  0, 0,
  0, ADC_MP(30), 0, 0, 4321, 3500, 121, 2800,
  310*4,320*4,330*4,340*4,        // CHT
  1100*4,1200*4,1300*4,1400*4     // EGT
},
{  
  1000L*12/20,    // 14 v
  246,    // OP - 60 psi
  200,         // 200 deg-F
  500,     // FP - 4 psi
  264,    // 10 gal
  356,     // 5 gal
  0, 0,
  0, ADC_MP(10), 0, 0, 4321, 3500, 123, 0, 
  310*4,320*4,330*4,340*4,        // CHT
  1100*4,1200*4,1300*4,1400*4     // EGT
}
};
#endif

// Call this every half second (in an IRQ)
inline void updateFuelFlow() {
  ffRunningInx++;
  ffRunningInx &= 3;
  fflowRate = fflowRunning - ffRunning[ffRunningInx];
  ffRunning[ffRunningInx] = fflowRunning;
}

inline void updateHobbs() {
  if (--hobbsCount == 0) {
    if (++(ee_status.hobbs) > 39999) {
      ee_status.hobbs = 0;
      ee_status.hobbs1k++;
    }
    eeUpdateDirty = true;
    hobbsCount = HOBBS_COUNT_INTERVAL;
  }
}

inline void updateRPM() {
  noInterrupts();
  if (tachCount) {
    unsigned long interval = latestTach_uS-savedTach_uS;
    rpm10 = ((60*1000000L/TACH_DIVIDER/10)*tachCount + interval/2) / interval;
    if (rpm10 < 0)
      rpm10 = 0;
  }
  else
    rpm10 = 0;
  savedTach_uS = latestTach_uS;
  tachCount = 0;
  interrupts();
}

void tachIRQ() {
  latestTach_uS = micros();                     // micros has a resolution of 4 uS. 
  tachCount++;
}                                                       

void fflowIRQ() {
  fflowCount++;
  fflowRunning++;
  if (fflowCount >= ee_settings.kFactor) {
    if (ee_status.fuel > 0) {
      ee_status.fuel--;
      eeUpdateDirty = true;
    }
    fflowCount = 0;
  }
}

// takes about 1.2 mS
void updateADC() {
  static bool initialized;
  
  for (byte i=0; i<13; i++) {
    short ar = ((i==12) ? rpm10 : analogRead(i));
    if (!longAverageByPin[i])
      adcSample[i].moving[adcIndex] = ar; 
    else {
      if (initialized) {
        adcSample[i].accumulate -= adcSample[i].accumulate/LONG_AVERAGE_LENGTH;
        adcSample[i].accumulate += ar;
      }
      else    
        adcSample[i].accumulate = LONG_AVERAGE_LENGTH * ar;
    }
  }
  adcIndex++;
  adcIndex &= 3;
  initialized = true;
}

short average4(short *samples) {
  short avg = 0;
  for (byte i=0; i<4; i++)
    avg += *samples++;
  return (avg+2)>>2;
}

void sensorSetup() {
 // RPM's are measured as microseconds between IRQ's. Occasional latency means 'wild' readings need to be thrown away
  attachInterrupt(digitalPinToInterrupt(TACH_SIGNAL),tachIRQ,RISING);

  // Fuel totalizer is assumed to be a 'Red Cube'
  pinMode(FUELF_SIGNAL, INPUT_PULLUP);
  attachInterrupt(digitalPinToInterrupt(FUELF_SIGNAL),fflowIRQ,RISING);  

  fflowCount = ee_settings.kFactor >> 1;  // in order to prevent cumulative fuel consumed error assume half a k-factor of a gallon was lost on last shutdown
}

short readSensor(const Sensor *s, byte n = 0) {
  if (s->pin == UNUSED_PIN)
    return FAULT;
    
  short p = s->pin + n;
  
#if SIMULATE_SENSORS
    return simulate[simState][p&(DUAL_BIT-1)]; 
#else
  short v;
  p &= 0x1f;
  
  byte t = s->type;
  if (p == HOBBS_SENSOR) { // Hobbs hours*10 (lowest 4 digits)
    v = ee_status.hobbs >> 2;
  }
  else if (p == FUELF_SENSOR) {      // Fuel flow GPH*10
    noInterrupts();
    v = short((multiply(fflowRate, int(10*3600L/40/2)) + (ee_settings.kFactor>>1)) / ee_settings.kFactor);
    interrupts();
  }
  else if (p == FUELR_SENSOR) { // Fuel remaining Gallons*10 (totalizer)
    noInterrupts();
    v = ee_status.fuel >> 2;
    interrupts();
  }
  else if (p == TACH_SENSOR) {  // RPM's
    v = average4(adcSample[12].moving) * 10;
  }
  else if (p < 16) { 
    if (longAverageByPin[p])
      v = adcSample[p].accumulate/LONG_AVERAGE_LENGTH;
    else
      v = average4(adcSample[p].moving);
    /* if (t == st_r240to33)
      v = interpolate(&r240to33, v);
    else */ 
    if (t == st_thermistor)
      v = interpolate(&thermistor, v);
    else if (t == st_volts5)
      v = multiplyAndScale(v,1000,10);    // change from 0-1023 to 0-999
   else if (t == st_volts1)
      v = multiplyAndScale(v,5000,10);    // change from 0-204 to 0-999
  }
  else if (p < 24) {     
    noInterrupts();
    v = tcTemp[p-16];
    interrupts();
    if (t == st_j_type_tcC || t == st_j_type_tcF)
     v = multiplyAndScale(v - tcTemp[8], 25599, 15) + tcTemp[8]; 
    if (v != FAULT && (t == st_k_type_tcF || t == st_j_type_tcF))
      v = (v*9)/5 + 32*4;
  }
  return v;     
#endif
}

short scaleValue(const Sensor *s, short val) {
  if (val == FAULT)
    return FAULT;
  return multiplyAndScale(s->vfactor,val+s->voffset, divisor);
}

byte alertStateNow(const Sensor *s, byte offset) {
 byte b = 0;
  if (s) {
    short v = scaleValue(s, readSensor(s,offset));
    if (v == FAULT) 
      b = ALERT_FAULT;
    else {
      if (v < s->lowWarning)
        b |= WARNING_LOW;
      else if (v < s->lowCaution)
        b |= CAUTION_LOW;
      if (v > s->highWarning)
        b |= WARNING_HIGH;
      else if (v > s->highCaution)
        b |= CAUTION_HIGH;
    }
  }
  return b;
}

inline bool isEngineRunning() {
  return !(bool(RUN_VOLT) || bool(RUN_OILP) || bool(RUN_TACH))
#if RUN_VOLT
  || scaleValue(&voltS, readSensor(&voltS)) > RUN_VOLT
#endif
#if RUN_OILP
  || scaleValue(&oilpS, readSensor(&oilpS)) > RUN_OILP
#endif
#if RUN_TACH
  || scaleValue(&tachS, readSensor(&tachS)) > RUN_TACH
#endif
  ;
}
