tomcourt/enguino/enguino/printAux.h

// Copyright 2017, Thomas Court
//
// 'Print' to the Aux display
// --------------------------
//
//  This file is part of Enguino.
//
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


// lookup port mapping to pins here: https://www.arduino.cc/en/Reference/PortManipulation
#define SCL_PIN 0
#define SCL_PORT PORTD
#define SDA_PIN 1
#define SDA_PORT PORTD
#define I2C_SLOWMODE 1
#define I2C_TIMEOUT 10

#if __AVR__
#include "softI2CMaster.h"
#endif

#define HT16K33_OSCILATOR_ON 0x21

#define HT16K33_BLINK_CMD         0x80
#define HT16K33_BLINK_DISPLAYON   0x01
#define HT16K33_BLINK_OFF     (HT16K33_BLINK_CMD | HT16K33_BLINK_DISPLAYON | 0)
#define HT16K33_BLINK_2HZ     (HT16K33_BLINK_CMD | HT16K33_BLINK_DISPLAYON | 2)
#define HT16K33_BLINK_1HZ     (HT16K33_BLINK_CMD | HT16K33_BLINK_DISPLAYON | 4)
#define HT16K33_BLINK_HALFHZ  (HT16K33_BLINK_CMD | HT16K33_BLINK_DISPLAYON | 6)

#define HT16K33_CMD_BRIGHTNESS 0xE0
#define HT16K33_BRIGHT_MAX    (HT16K33_CMD_BRIGHTNESS | 15)
#define HT16K33_BRIGHT_MIN    (HT16K33_CMD_BRIGHTNESS | 0)
#define HT16K33_ROW15_SCAN 0xA0

#define I2C_ADDRESS   (0x70<<1)   

// segments are aranged as follows (values are hexadecimal)
//
// +---  1 ---+
// |          |
// 20         2
// |          |
// +--- 40 ---+
// |          |
// 10         4
// |          |
// +---  8 ---+ *80

#define LED_TEXT(a,b,c,d) LED_ ## a, LED_ ## b, LED_ ## c, LED_ ## d

#define LED_0 0x3F
#define LED_1 0x06
#define LED_2 0x5B
#define LED_3 0x4F
#define LED_4 0x66
#define LED_5 0x6D
#define LED_6 0x7D
#define LED_7 0x07
#define LED_8 0x7F
#define LED_9 0x6F

#define LED_DP 0x80 // decimal point
#define LED__ 0x40  // minus sign
#define LED_  0x0   // blank

#define LED_A 0x77
#define LED_a 0x77    // looks like A
#define LED_B 0x7c    // looks like b
#define LED_b 0x7c
#define LED_C 0x39
#define LED_c 0x58
#define LED_D 0x5e    // looks like d
#define LED_d 0x5e
#define LED_E 0x79
#define LED_F 0x71
#define LED_f 0x71    // same as F
#define LED_G 0x3b
#define LED_g 0x6f
#define LED_H 0x76
#define LED_h 0x74
#define LED_i 0x4
#define LED_J 0x1e
#define LED_j 0x1e    // same as j
#define LED_L 0x38
#define LED_n 0x54
#define LED_O 0x3F    // same as 0
#define LED_o 0x5c
#define LED_P 0x73
#define LED_r 0x50
#define LED_S 0x6d    // same as 5
#define LED_s 0x6d    // same as S,5
#define LED_T 0x78    // looks like t
#define LED_t 0x78
#define LED_U 0x3e
#define LED_u 0x1c
#define LED_V 0x3e    // same as U
#define LED_v 0x1c    // same as u
#define LED_Y 0x6e
#define LED_y 0x6e    // same as Y
#define LED_Z 0x5b    // same as 2
#define LED_z 0x5b    // same as Z, 2

static const byte characterMap[] = { LED_0, LED_1, LED_2, LED_3, LED_4, LED_5, LED_6, LED_7, LED_8, LED_9 };

static byte ledBuffer[17];   // first byte is 0 for the address. Each 2 bytes after are the rows for each column
// The bits of each word correspond as follows: 0-3 are top digits, 4 is top colon, 5-8 are bottom digits, 9 is bottom colon, 11-14 are LEDs
#define TOP_LINE 0
#define BOTTOM_LINE 5

byte alertStatus, masterAlertStatus;

#define RED_LED    0x10
#define YELLOW_LED 0x18
#define GREEN_LED  0x8
byte alertToLED[3] = { GREEN_LED, YELLOW_LED, RED_LED};

#define STATUS_WARNING 2
#define STATUS_CAUTION 1
#define STATUS_NORMAL  0

#define LED_COLON 3

#define NEXT_KEY 1
#define NEXT_BIT 1
#define ACK_KEY 3
#define ACK_BIT 2
#define LAST_KEY 5
#define LAST_BIT 4

void writeI2C(byte *buffer, byte len) {
  if (i2c_start(I2C_ADDRESS | I2C_WRITE)) {
    while (len--) 
      if (!i2c_write(*buffer++)) 
         break;
  }
  i2c_stop();
}

// use this to set blink or brightness
void commandLED(byte command) {
  writeI2C(&command, 1);
}

byte readKeys() {
  static byte last = 0;
  
  byte keys[6];
  if (i2c_start(I2C_ADDRESS | I2C_WRITE)) 
    i2c_write(0x40);
  
  byte *buffer = keys;
  byte len = sizeof(keys) - 1;
  if (i2c_rep_start(I2C_ADDRESS | I2C_READ)) {
    while (len--) 
      *buffer++ = i2c_read(false);
    *buffer = i2c_read(true);
  }
 
  i2c_stop();

  byte out = 0;
  if (keys[LAST_KEY])
    out |= LAST_BIT;
  if (keys[ACK_KEY])
    out |= ACK_BIT;
  if (keys[NEXT_KEY])
    out |= NEXT_BIT;
  if (last != out) {
    last = out;
    return out;
  }
  return 0;
}

void writeSegments(byte digit, byte segments) {
  word bit = 1<<digit;
  for (int i=0; i<8; i++) {
    if (segments & 1)
      ((word *)(ledBuffer+1))[i] |= bit;
    segments >>= 1;
  }
}

void writeLED() {
  writeI2C(ledBuffer, sizeof(ledBuffer));
}

// must prevent more than 4 digits from printing
void printLEDRawDigits(byte offset, word val) {
  do {
    writeSegments(offset++, characterMap[val%10]);
    val /= 10;
  } while (val);
}

// Number is clipped at 999 and has a decimal point at 1.
// Numbers greater than 99 are displayed whole, smaller in tenths
void printLEDRawHalfDigits(byte offset, word number) {
  if (short(number) == FAULT) {
    writeSegments(offset, LED__);
    writeSegments(offset+1, LED__);
  }
  else {
    if (number < 0)
      number = 0;
    if (number > 999)
      number = 999;
    if (number < 100) {
      printLEDRawDigits(offset, number);
      writeSegments(offset+1, LED_DP);
    }
    else
      printLEDRawDigits(offset, number/10);
  }
}

void prepareLED() {
  memset(ledBuffer, 0, sizeof(ledBuffer));
    // 4/9 duty cycle for caution/alarm indicator  (22 ma max current, 13 ma typical)
  byte ledState = (alertToLED[alertStatus]<<2) | alertToLED[masterAlertStatus];
  byte halfTimeColor = ledState;
  if ((ledState&YELLOW_LED) == YELLOW_LED)
    halfTimeColor ^= RED_LED;
  if ((ledState&(YELLOW_LED<<2)) == (YELLOW_LED<<2))
    halfTimeColor ^= (RED_LED << 2);    
  ledBuffer[14] = halfTimeColor;  
  ledBuffer[6] = ledBuffer[2] = ledBuffer[10] = ledState;     
}

// -------------------------------------------------------

void printLEDSetup() {
  i2c_init();
  commandLED(HT16K33_OSCILATOR_ON);
  commandLED(HT16K33_BLINK_OFF);
  commandLED(HT16K33_BRIGHT_MAX);
  commandLED(HT16K33_ROW15_SCAN);

  ledBuffer[0] = 0;
}

// print a text message to the LED on line 0 or 1
void printLED(byte offset, byte a, byte b, byte c, byte d) {
  writeSegments(offset+3, a);
  writeSegments(offset+2, b);
  writeSegments(offset+1, c);
  writeSegments(offset+0, d);
}

// print a text message to the LED
void printLED(byte offset, byte *txt) {
  printLED(offset, txt[0], txt[1], txt[2], txt[3]);
}

// print the fuel gauge (e.g. 2.5:17)  (left tank : right tank)
void printLEDFuel(byte offset, short left, short right) {
  printLEDRawHalfDigits(offset+2, left);
  printLEDRawHalfDigits(offset, right);
  writeSegments(offset+4, LED_COLON);
}

// print the 'number' to 'line' 0 or 1, place a decimal point 'decimal' digits to the left
void printLED(byte offset, short number, byte decimal) {
  if (number == FAULT) {
    printLED(offset, LED_TEXT(i,n,o,P));
  }
  else {
    if (number < 0)
      number = 0;
    if (number > 9999)
      number = 9999;
    printLEDRawDigits(offset, number);
    if (decimal != 0)
      writeSegments(offset+decimal, LED_DP); 
  }
 }
