tomcourt/enguino/enguino/tcTemp.h

// Copyright 2017, Thomas Court
//
// Measure thermocouple tempertaures in the background
// ---------------------------------------------------
// also handles periodic real-time activites for Enguino
//
//  This file is part of Enguino.
//
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


// Pinout for Ocean Design's Thermocouple Multiplexer Shield
#define PINEN 7 // TC Mux Enable pin
#define PINA0 4 // TC Mux Address 0 pin
#define PINA1 5 // TC Mux Address 1 pin
#define PINA2 6 // TC Mux Address 2 pin
#define PINSO 12 //TC ADC Slave Out pin (MISO)
#define PINSC 13 //TC ADC Serial Clock (SCK)
#define PINCS 9  //TC ADC Chip Select

volatile short tcTemp[9];    // in quarter deg. C, tcTemp[8] is the interal reference temp, disable IRQ's to access these

volatile bool eighthSecond;
volatile byte halfSecond = 0;
volatile byte wholeSecond = 0;

short readSPI() {
  word v = 0;
  for (byte i=16; i; i--) {
    v <<= 1;
    digitalWrite(PINSC, HIGH);
    // 100nS min. delay implied
    v |= digitalRead(PINSO);
    digitalWrite(PINSC, LOW);   // request next serial bit
    // 100nS min. delay implied
  }
  return v;
}

void tcTempSetup() {
  pinMode(PINEN, OUTPUT);
  pinMode(PINA0, OUTPUT);
  pinMode(PINA1, OUTPUT);
  pinMode(PINA2, OUTPUT);
  pinMode(PINSO, INPUT);
  pinMode(PINCS, OUTPUT);
  pinMode(PINSC, OUTPUT);

  digitalWrite(PINEN, HIGH);   // enable the mux all the time
  digitalWrite(PINSC, LOW);    // put clock in low
  digitalWrite(PINCS, LOW);    // stop conversion, start serial interface

  // Timer0's overflow is used for millis() - setup to interrupt
  // in the middle and call the "Compare A" function below
  OCR0A = 0x80;
  TIMSK0 |= _BV(OCIE0A);
}

// Interrupt is called every millisecond (a little slower, actually 976.5625 Hz)
SIGNAL(TIMER0_COMPA_vect)
{
  static byte ms = 0;
  static byte ch = 0;

#if DEBUG
  checkFreeRam();
#endif

  if (ms == 0) {
    // select the thermocouple channel on the mux
    digitalWrite(PINA0, ch&1);
    digitalWrite(PINA1, ch&2);
    digitalWrite(PINA2, ch&4);
    // ... wait a while for the capacitor on the ADC input to charge (< .1 mS actually needed)
  }
  else if (ms == 21) {
    // begin conversion
    digitalWrite(PINCS, HIGH);
    // ... wait 100 mS for conversion to complete
  }
  else if (ms == 121) {   // spec says 100mS, IRQ's are a bit slower, so this is >100mS
    // stop conversion, start serial interface
    digitalWrite(PINCS, LOW);
    // 100nS min. delay implied

    short rawTC = readSPI();
    short rawIT = readSPI();

    short tempC = rawTC / 4;
    if (rawTC & 1) {
      if (rawIT & 7)
        tempC = FAULT;
    }
    tcTemp[ch] = tempC;

    if (++ch == 8) {
      tcTemp[8] = rawIT / 64; // internal temperature reduced to quarter degree C
      ch = 0;
    }
    ms = 255; // final ++ will make this 0 for next time around

    eighthSecond = true;
    halfSecond++;
    wholeSecond++;

    if (halfSecond == 4) // every half second
      updateFuelFlow();  // fuel flow has to be sampled at accurate intervals for accurate readings
  }
  ms++;
}
