tomcourt/enguino/enguino/utility.h

// Copyright 2017, Thomas Court
//
// Utility functions for Enguino
// -----------------------------
//
//  This file is part of Enguino.
//
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


// compile time sin() and cos() for calculating round gauges position in an x, y plane (sin/cos only work from -pi/2 to pi/2)
// https://github.com/pkhuong/polynomial-approximation-catalogue/tree/master/double
#define SIN(x)  ( (x) + -0.166656810730001*(x)*(x)*(x) + 0.008312366210465815*(x)*(x)*(x)*(x)*(x) + -1.8492181558254177e-4*(x)*(x)*(x)*(x)*(x)*(x)*(x) )
#define COS(x)  ( 1.0 + -0.4999356307314411*(x)*(x) + 0.04150706685139252*(x)*(x)*(x)*(x) + -0.0012757519849685426*(x)*(x)*(x)*(x)*(x)*(x)             )

// extend above functions to -pi/2 to 3/2 pi
#define SIN2(x) ( ((x)<=PI/2.) ? SIN(x) : -SIN((x)-PI) )
#define COS2(x) ( ((x)<=PI/2.) ? COS(x) : -COS((x)-PI) )



void logTime(unsigned long start, const char *description) {
  Serial.print(description);
  Serial.print(' ');
  Serial.print(short(millis()-start));
  Serial.print("ms\n");
}

void logValue(short val, const char *description) {
  Serial.print(description);
  Serial.print('=');
  Serial.println(val);
 }

void logValue(short val, short num) {
  Serial.print(num);
  Serial.print('=');
  Serial.println(val);
}

void logText(const char *text = "") {
  Serial.println(text);
}

#if DEBUG_RAM_USE 
volatile short minFreeRam = 10000;

void checkFreeRam() {
  extern short __heap_start, *__brkval;
  short n = (short) &n - (__brkval == 0 ? (short) &__heap_start : (short) __brkval);
  if (n < minFreeRam)
    minFreeRam = n;
}
#endif

#if __AVR__
// https://github.com/rekka/avrmultiplication
// signed16 * signed16
// 22 cycles
#define MultiS16X16to32(longRes, intIn1, intIn2) \
asm volatile ( \
"clr r26 \n\t" \
"mul %A1, %A2 \n\t" \
"movw %A0, r0 \n\t" \
"muls %B1, %B2 \n\t" \
"movw %C0, r0 \n\t" \
"mulsu %B2, %A1 \n\t" \
"sbc %D0, r26 \n\t" \
"add %B0, r0 \n\t" \
"adc %C0, r1 \n\t" \
"adc %D0, r26 \n\t" \
"mulsu %B1, %A2 \n\t" \
"sbc %D0, r26 \n\t" \
"add %B0, r0 \n\t" \
"adc %C0, r1 \n\t" \
"adc %D0, r26 \n\t" \
"clr r1 \n\t" \
: \
"=&r" (longRes) \
: \
"a" (intIn1), \
"a" (intIn2) \
: \
"r26" \
)
#endif

// multiply 16 x 16 signed values and return the 32 bit result
// this is a smaller and faster version of: (long(a) * long(b);
long multiply(short a, short b) {
#if __AVR__
  long res;

  MultiS16X16to32(res, a, b);
  return res;
#else
  return long(a) * long(b);
#endif
}

short multiplyAndScale(short a, short b, byte shift) {
  return short((multiply(a, b) + (1<<(shift-1))) >> shift);
}

// interpolate values using table, returns FAULT instead of extrapolating
short interpolate(const InterpolateTable *table, short value) {
  short x = table->start;
  if (value < x)
    return FAULT;
  short i = table->n;
  const byte *diff = table->log2diff;
  const short  *result = table->result;
  for(;;) {
    if (value == x)
      return *result;
    if (--i == 0)
      return FAULT;
    short x1 = x + (1 << *diff);
    if (value < x1)
      return short((multiply(*result,x1-value) + multiply(result[1], value-x)) >> *diff);
    x = x1;
    diff++;
    result++;
  }
}

// sort a small list using insertion sort O(n^2) worst case
void sort(short *list, byte n) {
  for (byte i=1; i<n; i++) {
    for (byte j=i; j>0 && list[j-1] > list[j]; j--) {
      short t = list[j];
      list[j] = list[j-1];
      list[j-1] = t;
    }
  }
}
