tomcourt/enguino/(commit log)

2017-06-20 proto code for LED
    fullscreen for home app
2017-06-23 Cleaner config
    inop instead of open and short
    [config.h, egTypes.h, enguino.ino, printEthernet.h, printGauges.h, printLED.h, tcTemp.h]
2017-07-05 Fixed i2c halting, blanks display if link lost
    [config.h, enguino.ino, printGauges.h, printLED.h, printWeb.h]
2017-07-06 Switch and dimming added
2017-07-13 Updated calibration
2017-07-22 Update calibaration
    Added aux warning screen, automatic switching
2017-07-23 simplify config with arc's
    better warning caution naming.
    all sensors now 0 to 1000.
    specific voltage based divider type.
2017-07-25 CHT/EGT fixes
    MP scaling fix
    [config.h, printGauges.h, sensors.h]
2017-07-29 Code cleanup
    Moved Aux display to standard i2c pints
2017-07-30 Code cleanup
    Timeout before aux display reverts to default page
    [config.h, enguino.ino, printAux.h, sensors.h]
2017-07-31 Moved TBDs and Future stuff
    To github’s issue tracker
2017-08-04 Added simulator
    Changed int’s to short’s in code. Consistent use of const and other
    code cleanups.
    [config.h, controlAux.h, egTypes.h, enguino.ino, i2cLED.h, main.cpp, persist.h, printAux.h]
2017-08-05 Fixes to Aux operation
    Shows battery voltage on startup
    Clears blinking when switching pages
    No longer blinks second line (if not info page)
    [controlAux.h, enguino.ino, printGauges.h, sensors.h]
2017-08-11 Sloshing fuel tank fix
    Also, fix for the slow update of the aux display problem… seprate half
    and whole second tracking.
    [config.h, egTypes.h, enguino.ino, main.cpp, printGauges.h, sensors.h, tcTemp.h, utility.h]
2017-09-01 Calibration fix
    Better fit for gauge readings.
    [config.h, egTypes.h, enguino.ino, printGauges.h, printWeb.h, sensors.h, tcTemp.h]
2017-11-07 New Aux display code changes
    New aux display is a custom circuit board with a single HT16k33
    controller. It has 3 buttons: Last - Ack - Next. It is much more
    compact, it fits in a 2.25” instrument hole. Schematics, board layout
    and 3d files for an enclosure are coming.
2018-05-24 Retiring project
    Including aux display board and enclosure. Schematic for new enguino
    shield board.
    [EnguinoAuxDisplaySchematic.sch, EnguinoShieldSchematic.sch]
